JPL24hub/EVMx/rtl/EVMx/keccak256/PKG_KECCAK.vhdl

-- The Keccak sponge function, designed by Guido Bertoni, Joan Daemen,
-- Micha�l Peeters and Gilles Van Assche. For more information, feedback or
-- questions, please refer to our website: http://keccak.noekeon.org/

-- Implementation by the designers,
-- hereby denoted as "the implementer".

-- To the extent possible under law, the implementer has waived all copyright
-- and related or neighboring rights to the source code in this file.
-- http://creativecommons.org/publicdomain/zero/1.0/

library IEEE;
use IEEE.std_logic_1164.all;
package PKG_KECCAK is

	--checksum 
	
	subtype Lane is std_logic_vector(63 downto 0);
	type StateArray is array(24 downto 0) of Lane;
	function "=" (a : StateArray; b : StateArray) return boolean;
	
    type sha3_mode is (append, init);
	type sha3_type is (sha224, sha256, sha384, sha512);
	function to_StateArray(v : std_logic_vector(1599 downto 0)) return StateArray;
	function to_std_logic_vector(s : StateArray) return std_logic_vector;
	function getHashSize(t : sha3_type) return natural;


end package PKG_KECCAK;

package body PKG_KECCAK is


	function getHashSize(t : sha3_type) return natural is
	begin
		case t is
			when sha224 => return 224;
			when sha256 => return 256;
			when sha384 => return 384;
			when sha512 => return 512;
		end case;
	end function getHashSize;

	function "=" (a : StateArray; b : StateArray) return boolean is
	begin
		for i in 0 to 24 loop
			if a(i) /= b(i) then
				return false;
			end if;
		end loop;
		return true;
	end function;

	function to_StateArray(v : std_logic_vector(1599 downto 0)) return StateArray is
		variable s : StateArray;
	begin
		for i in 0 to 24 loop
			s(i) := v(i * 64 + 63 downto i * 64);
		end loop;
		return s;
	end function to_StateArray;

	function to_std_logic_vector(s : StateArray) return std_logic_vector is
		variable v : std_logic_vector(1599 downto 0);
	begin
		for i in 0 to 24 loop
			v(i * 64 + 63 downto i * 64) := s(i);
		end loop;
		return v;
	end function to_std_logic_vector;

end package body PKG_KECCAK;
