JPL24hub/EVMx/rtl/EVMx/keccak256/keccak_iota.vhdl

-- The Keccak sponge function, designed by Guido Bertoni, Joan Daemen,
-- Micha�l Peeters and Gilles Van Assche. For more information, feedback or
-- questions, please refer to our website: http://keccak.noekeon.org/

-- Implementation by the designers,
-- hereby denoted as "the implementer".

-- To the extent possible under law, the implementer has waived all copyright
-- and related or neighboring rights to the source code in this file.
-- http://creativecommons.org/publicdomain/zero/1.0/

library IEEE;
use IEEE.std_logic_1164.all;
use IEEE.numeric_std.all;
use work.PKG_KECCAK.all;

entity keccak_iota is
port(
	input : in StateArray;
	roundIndex : in Natural range 0 to 23;
	output : out StateArray
);
end entity keccak_iota;

architecture arch of keccak_iota is

	function const(value : std_logic_vector(63 downto 0)) return Lane is
	begin
		return Lane(value);
	end function const;
    
    signal roundConstant : Lane;
	
begin
    
	with roundIndex select roundConstant <=
        const(x"0000000000000001") when  0,
        const(x"0000000000008082") when  1,
        const(x"800000000000808a") when  2,
        const(x"8000000080008000") when  3,
        const(x"000000000000808b") when  4,
        const(x"0000000080000001") when  5,
        const(x"8000000080008081") when  6,
        const(x"8000000000008009") when  7,
        const(x"000000000000008a") when  8,
        const(x"0000000000000088") when  9,
        const(x"0000000080008009") when 10,
        const(x"000000008000000a") when 11,
        const(x"000000008000808b") when 12,
        const(x"800000000000008b") when 13,
        const(x"8000000000008089") when 14,
        const(x"8000000000008003") when 15,
        const(x"8000000000008002") when 16,
        const(x"8000000000000080") when 17,
        const(x"000000000000800a") when 18,
        const(x"800000008000000a") when 19,
        const(x"8000000080008081") when 20,
        const(x"8000000000008080") when 21,
        const(x"0000000080000001") when 22,
        const(x"8000000080008008") when 23;
	
	output(0) <= input(0) xor roundConstant;
	
	forward : for i in 1 to 24 generate
		output(i) <= input(i);
	end generate;
end architecture arch;
